WtfWhyMe/KeyTracker/Poster.pdf

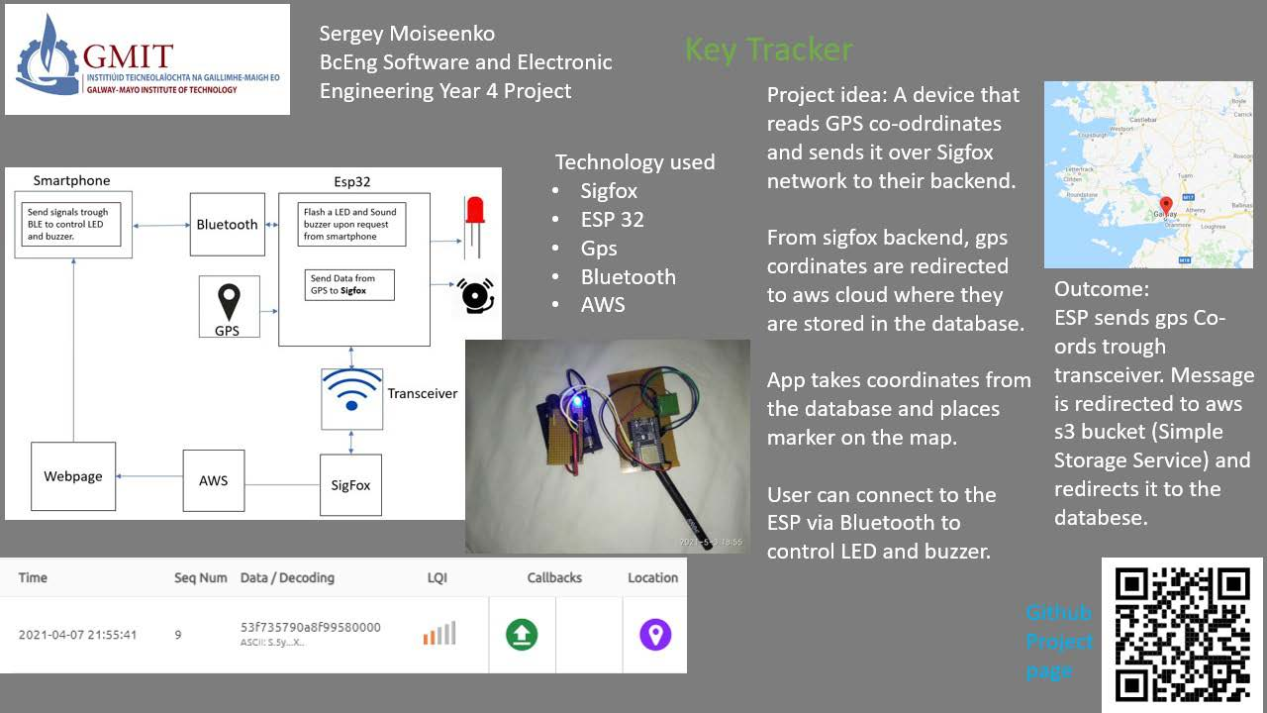
[picture p11: page 1]
